vern-da-coda/lasius/docs/README.md

# Lasius Hexapod: Documentation

---

[Index](../README.md) | [Software](../software/README.md) | [Hardware](../hardware/README.md) | [Docs](../docs/README.md) | [Data](../data/README.md) | [Scripts](../scripts/README.md) |<br>
[Domain Architecture](domain_architecture.md) | [Decisions](hardware/decisions.md) | [Closed Loop](hardware/closed_loop_plan.md) | [Wiring](hardware/wiring_plan.md) | [Gamepad](pilot/gamepad_stadia.md) | [Roadmap](roadmap.md) |

---

Specifications, architectural decisions, wiring schematics, and development roadmaps for the **Lasius** 18-DOF Hexapod robot.

**Interactive 3D Digital Twin Demo:** [**https://dashboard.lasius.kaemmereit.de/**](https://dashboard.lasius.kaemmereit.de/) – Experience the browser-based simulation directly.

## Documentation Index

### System & Architecture
- [**System & Domain Architecture Specification**](domain_architecture.md):
  End-to-end domain map covering Mechanics (3-Level Hardware-as-Code), Power & Sensor Electronics, 50 Hz Harmonic Locomotion Core, 3D Digital Twin, Gamepad Teleoperation, PyBullet Physics, and Gymnasium Reinforcement Learning.
- [**Audio Podcast Architecture Briefing**](audio_briefing_domain.md):
  Audio learning script covering physical CAD modeling, PyBullet simulation, kinematics, and software architecture.

### Hardware & Electronics
- [**Electronics Testbench Bring-Up Status & Handover**](hardware/testbench_bringup_status.md):
  **Active Focus:** Status of the 6-step bench Bring-Up for the TCA9548A I2C multiplexer and ADS1115 16-bit ADCs.
- [**Electronics Testbench Reference Guide**](hardware/electronics_testbench_guide.md):
  Technical guide with exact wiring tables, 3.3V logic protection, I2C address topology, and diagnostic procedures.
- [**Hardware Decisions & 3D Printing Specifications**](hardware/decisions.md):
  Comprehensive documentation of the physical architecture: 2S LiPo battery, 20A UBEC (6.0V servo bus), 5V/3A buck converter for Raspberry Pi, Adafruit STEMMA QT / Qwiic I2C sensor bus topology, BNO085 9-DOF IMU, INA228 power monitors, VL53L4CD ToF distance sensors, MCP23017 foot switch expander, and slicer/material settings for PETG limb parts.
- [**18-DOF Closed-Loop Feedback Plan**](hardware/closed_loop_plan.md):
  Architecture for closed-loop angle feedback by tapping internal servo potentiometers into 6× ADS1115 16-bit ADCs via a TCA9548A I2C multiplexer with 100 nF RC low-pass filtering.
- [**Electrical Wiring & Connection Plan**](hardware/wiring_plan.md):
  Detailed pinouts, bus addresses, and terminal blocks for the dual PCA9685 PWM drivers, sensor bus, and power distribution rails.

### Teleoperation & Controls
- [**Google Stadia Controller & Teleoperation Guide**](pilot/gamepad_stadia.md):
  Linux joystick driver (`/dev/input/js0`), raw axis mappings, button layouts, deadzone filtering, and Bluetooth pairing instructions for the Google Stadia Controller.

### Project Roadmap
- [**Project Roadmap & Backlog**](roadmap.md):
  Prioritized task list, sprint backlog, mechanical reconstruction goals, and feature milestones.
