vern-da-coda/lasius/hardware/mechanics/drawings/references/ads1115_reference.jpg

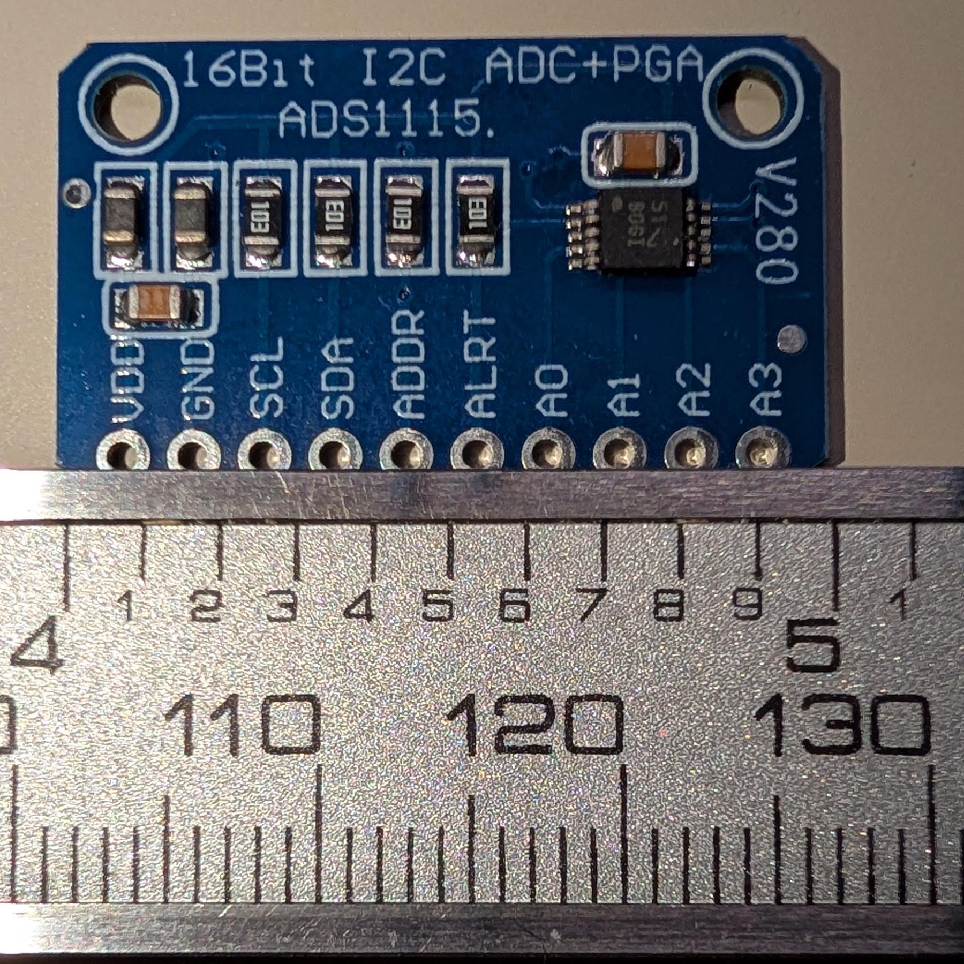
hardware/mechanics/drawings/references/ads1115_reference.jpg
