vern-da-coda/lasius/hardware/mechanics/drawings/sketches/femur_servo_wangen.png

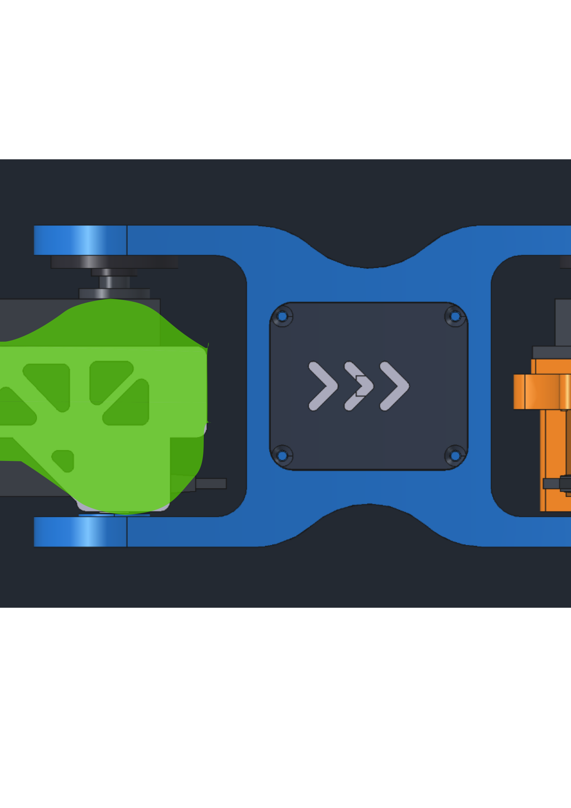
hardware/mechanics/drawings/sketches/femur_servo_wangen.png
