vern-da-coda/lasius/hardware/mechanics/export/sim_preview.png

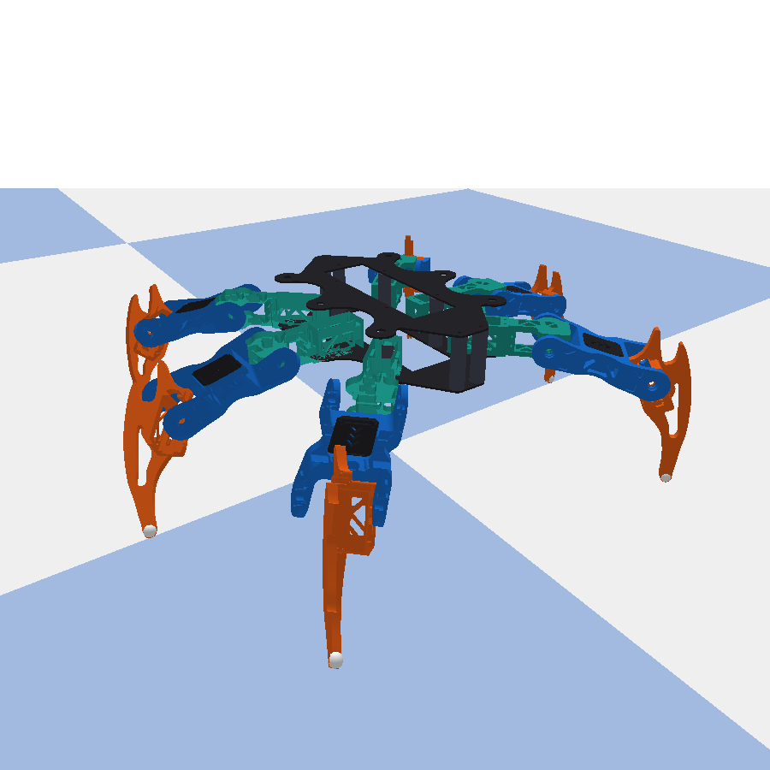
hardware/mechanics/export/sim_preview.png
