vern-da-coda/lasius/hardware/electronics/wiring/02_single_leg_feedback_harness.bom.tsv

Id | Description | Qty | Unit | Designators
1 | Cable, 1 x 28 AWG | 0.58 | m | Coxa_Pot_Line, Femur_Pot_Line, Tibia_Pot_Line
2 | Cable, 2 x 28 AWG | 0.35 | m | Foot_Switch_Line
3 | Cable, 3 x 24 AWG | 0.64 | m | Coxa_Power_PWM, Femur_Power_PWM, Tibia_Power_PWM
4 | Cable, 4 x 28 AWG | 0.2 | m | SubBus_I2C_Feed
5 | Cable, 7 x 26 AWG | 0.01 | m | Direct_Header_Solder
6 | Connector, ADS1115 16-Bit ADC Breakout, Leg Telemetry Module (Addr 0x48), 9 pins, OG | 1 |  | ADS1115_Leg_Board
7 | Connector, Omron D2F-L Microswitch, Tactile Foot Contact (Active-Low), 2 pins, BK | 1 |  | Foot_Sensor
8 | Connector, PCA9685 4-Channel Header Block, Channels 4k, 4k+1, 4k+2 (4k+3 Spare), 12 pins, BU | 1 |  | PCA9685_Leg_Block
9 | Connector, Passive Filter + Pull-Up Network, Soldered Directly Under ADS1115 Header, 7 pins, YE | 1 |  | Onboard_RC_Pullup
10 | Connector, Reely NR-645 MG BB, Modified 4-Wire Servo (Coxa), 4 pins, GY | 1 |  | Servo_Coxa
11 | Connector, Reely NR-645 MG BB, Modified 4-Wire Servo (Femur), 4 pins, GY | 1 |  | Servo_Femur
12 | Connector, Reely NR-645 MG BB, Modified 4-Wire Servo (Tibia), 4 pins, GY | 1 |  | Servo_Tibia
13 | Connector, TCA9548A Sub-Channel Uplink (CHx), 4-Pin I2C + 3.3V Feed, 4 pins, BU | 1 |  | TCA9548A_SubBus
