vern-da-coda/lasius/hardware/mechanics/export/step/body_assembly.step

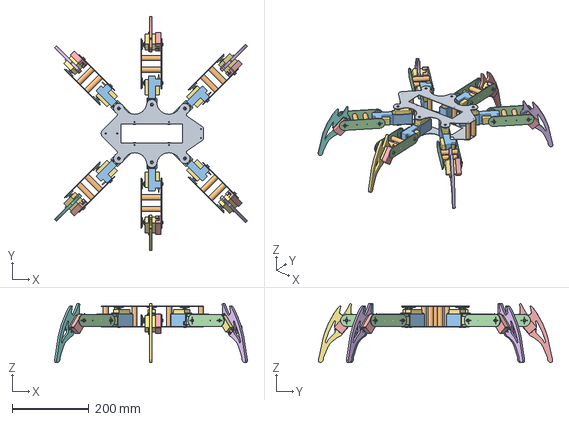
[picture p8: CAD file, 2026-11-07]
hardware/mechanics/export/step/body_assembly.step
502.7 x 610.7 x 154.1 mm
