vern-da-coda/lasius/hardware/mechanics/export/step/custom/v2/leg_assembly.step

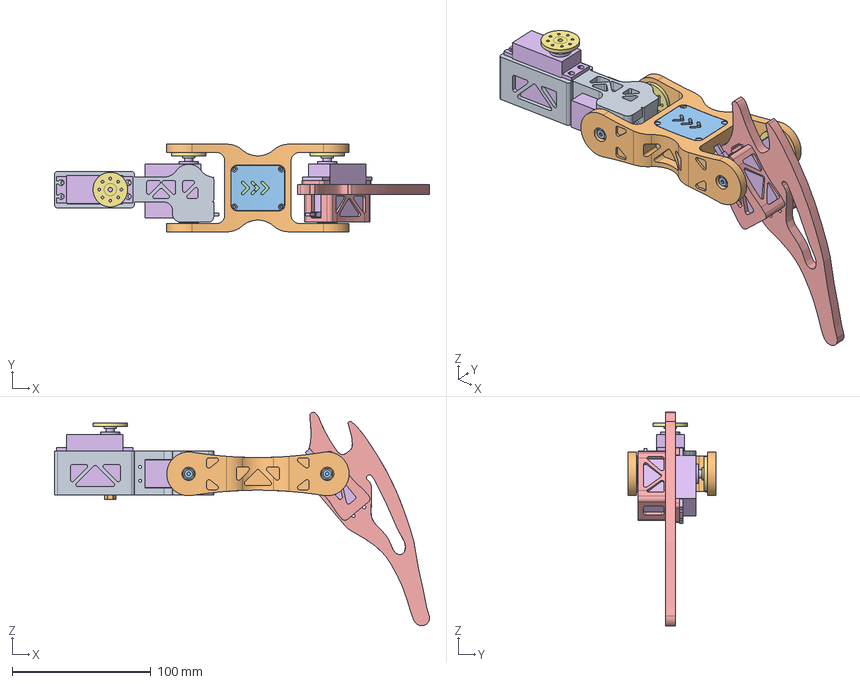
[picture p9: CAD file, 2026-11-09]
hardware/mechanics/export/step/custom/v2/leg_assembly.step
270.6 x 63.3 x 154.1 mm
