vern-da-coda/lasius/hardware/mechanics/export/step/custom/v2/body_assembly.step

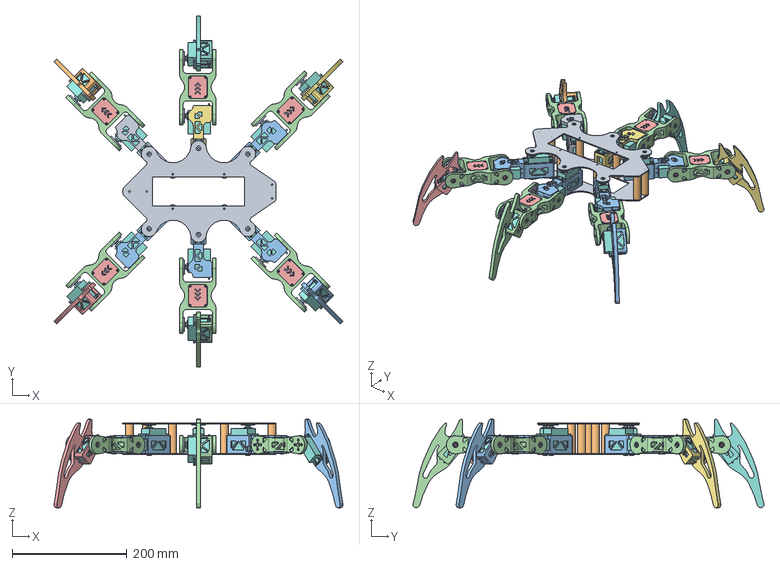
[picture p10: CAD file, 2026-11-09]
hardware/mechanics/export/step/custom/v2/body_assembly.step
502.7 x 610.7 x 154.1 mm
