vern-da-coda/lasius/hardware/mechanics/export/step/custom/v2/parts/coxa_bracket.step

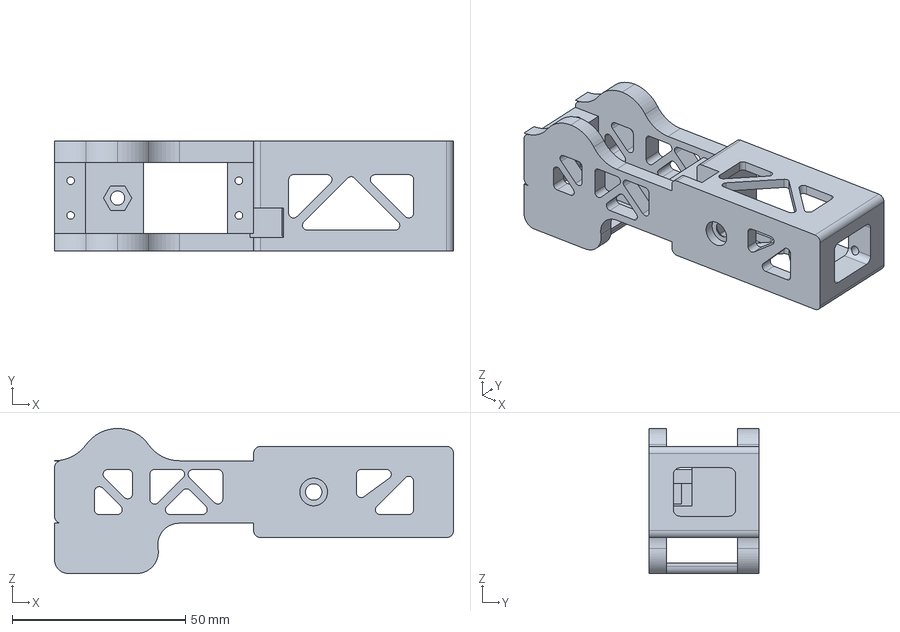
[picture p11: CAD file, 2026-11-09]
hardware/mechanics/export/step/custom/v2/parts/coxa_bracket.step
115.0 x 31.7 x 41.8 mm
