vern-da-coda/lasius/hardware/mechanics/export/stl/custom/v2/parts/femur_cover.stl

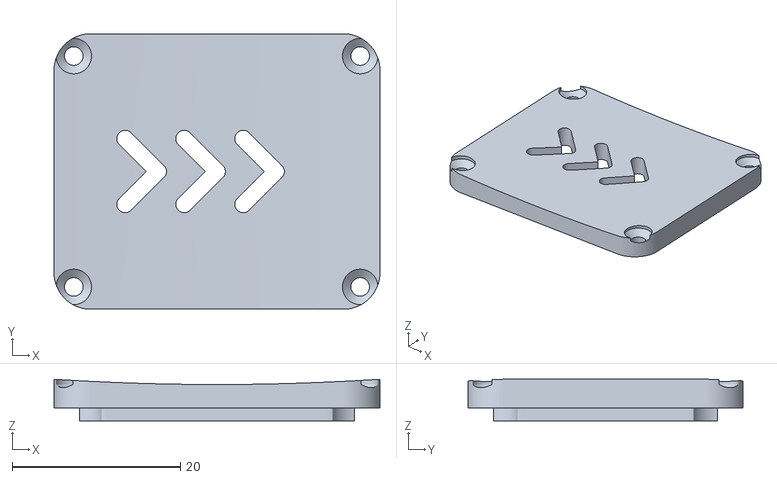
[picture p12: CAD file, 2026-11-09]
hardware/mechanics/export/stl/custom/v2/parts/femur_cover.stl
38.7 x 32.7 x 4.93
