vern-da-coda/lasius/hardware/mechanics/export/step/custom/v2/parts/femur.step

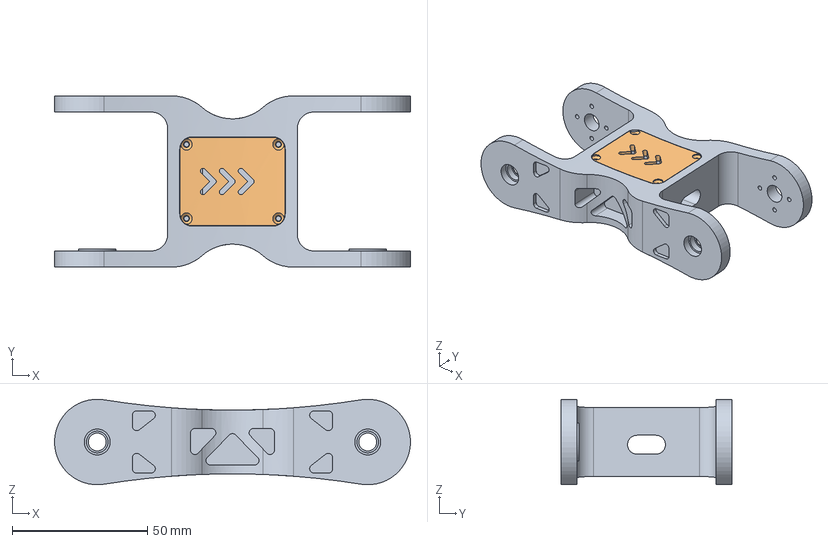
[picture p13: CAD file, 2026-11-08]
hardware/mechanics/export/step/custom/v2/parts/femur.step
131.6 x 63.3 x 31.6 mm
