vern-da-coda/lasius/hardware/mechanics/export/step/custom/v2/parts/tibia.step

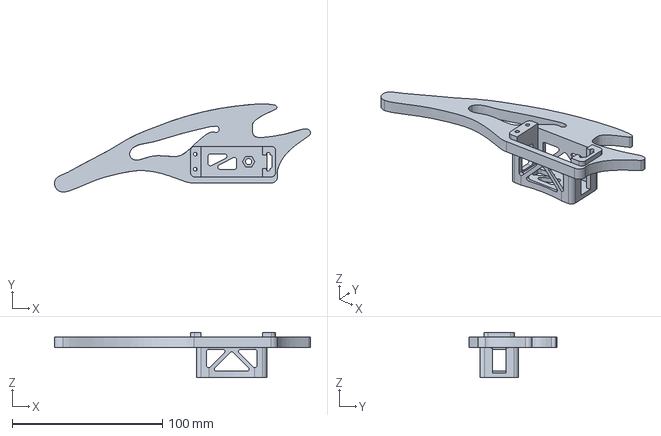
[picture p14: CAD file, 2026-11-08]
hardware/mechanics/export/step/custom/v2/parts/tibia.step
170.3 x 58.6 x 30.0 mm
