vern-da-coda/lasius/hardware/mechanics/export/step/cots/servo_nr645.step

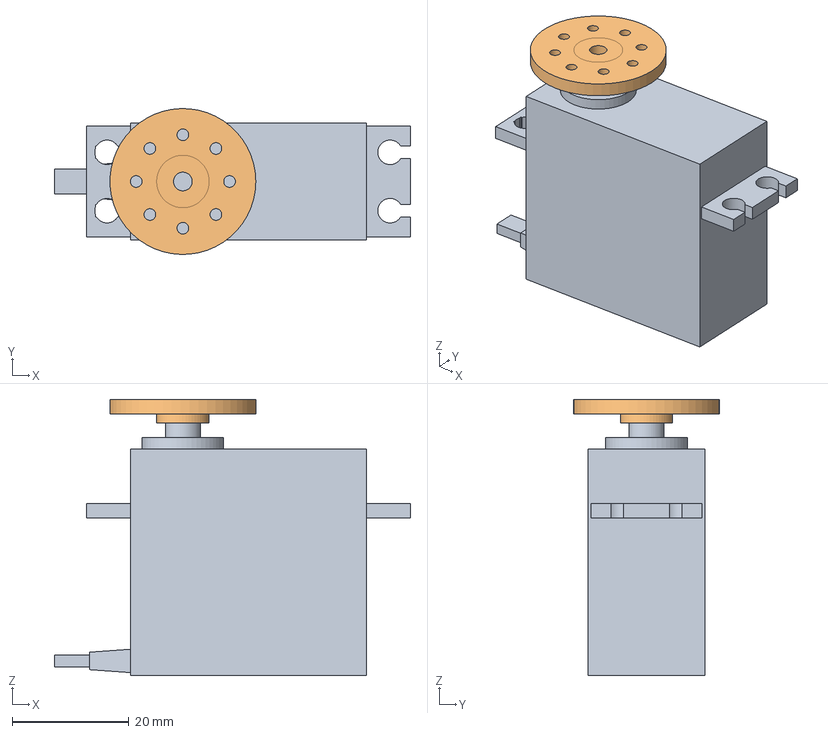
[picture p15: CAD file, 2026-11-06]
hardware/mechanics/export/step/cots/servo_nr645.step
61.0 x 25.0 x 47.3 mm
