vern-da-coda/lasius/hardware/mechanics/models/cots/nut_m4_din439.FCStd

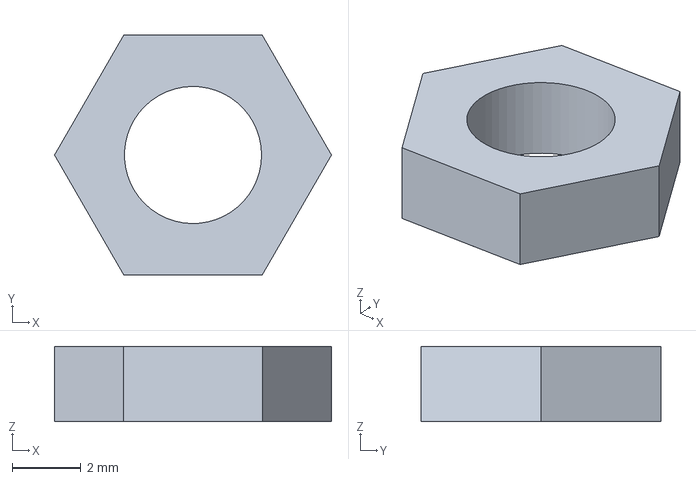
[picture p16: CAD file, 2026-11-09]
hardware/mechanics/models/cots/nut_m4_din439.FCStd
8.08 x 7.00 x 2.20 mm
