vern-da-coda/lasius/hardware/mechanics/models/cots/washer_m4_shim.FCStd

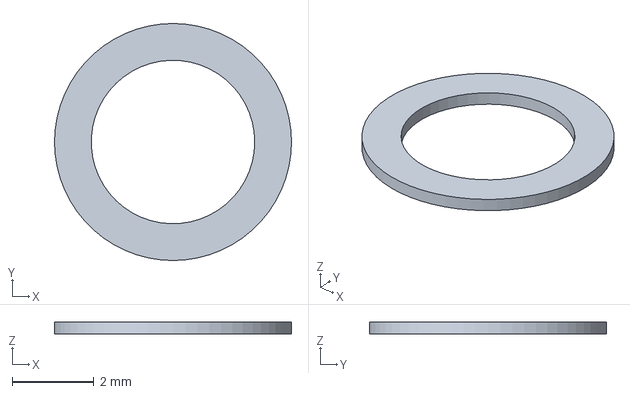
[picture p17: CAD file, 2026-11-06]
hardware/mechanics/models/cots/washer_m4_shim.FCStd
5.80 x 5.80 x 0.3 mm
