vern-da-coda/lasius/hardware/mechanics/models/cots/screw_m4_countersunk.FCStd

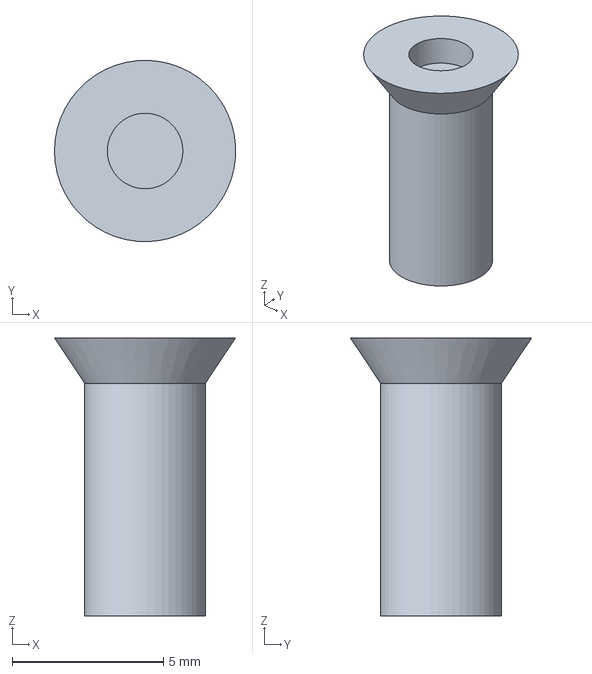
[picture p18: CAD file, 2026-11-06]
hardware/mechanics/models/cots/screw_m4_countersunk.FCStd
5.99 x 6.00 x 9.20 mm
