vern-da-coda/lasius/hardware/mechanics/models/cots/bearing_684_6x3.FCStd

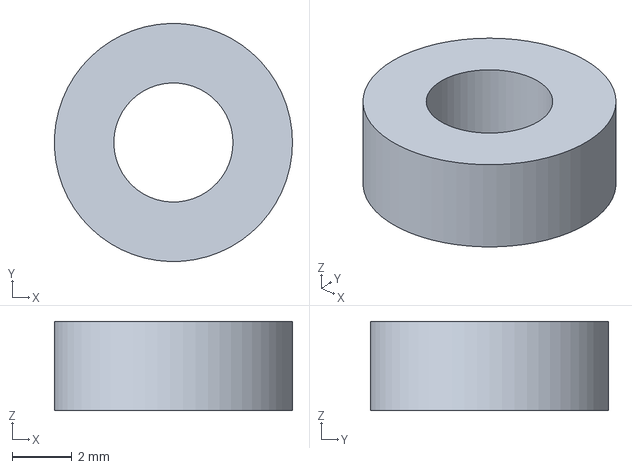
[picture p19: CAD file, 2026-11-06]
hardware/mechanics/models/cots/bearing_684_6x3.FCStd
7.99 x 8.00 x 3.00 mm
