vern-da-coda/lasius/hardware/mechanics/models/cots/nut_m4_hex.FCStd

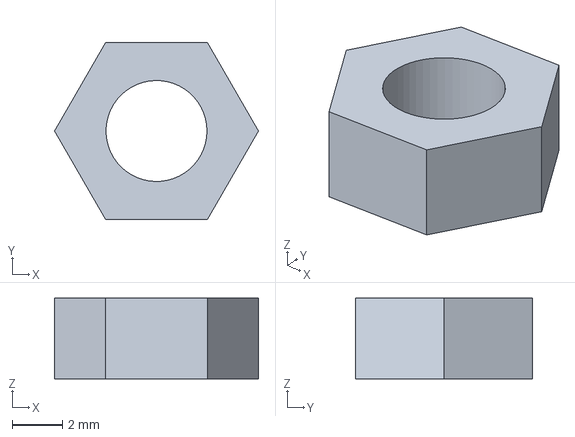
[picture p20: CAD file, 2026-11-06]
hardware/mechanics/models/cots/nut_m4_hex.FCStd
8.08 x 7.00 x 3.20 mm
