vern-da-coda/lasius/hardware/mechanics/export/step/custom/v1/leg_assembly.step

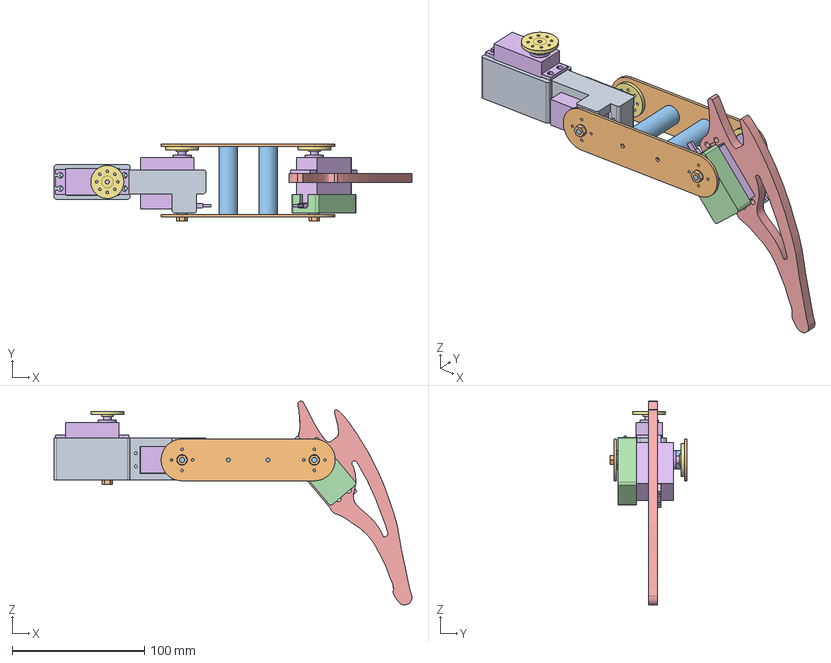
[picture p21: CAD file, 2026-11-09, an earlier design]
hardware/mechanics/export/step/custom/v1/leg_assembly.step
270.6 x 58.5 x 154.1 mm
