vern-da-coda/lasius/hardware/mechanics/export/step/custom/v1/parts/body_bottom.step

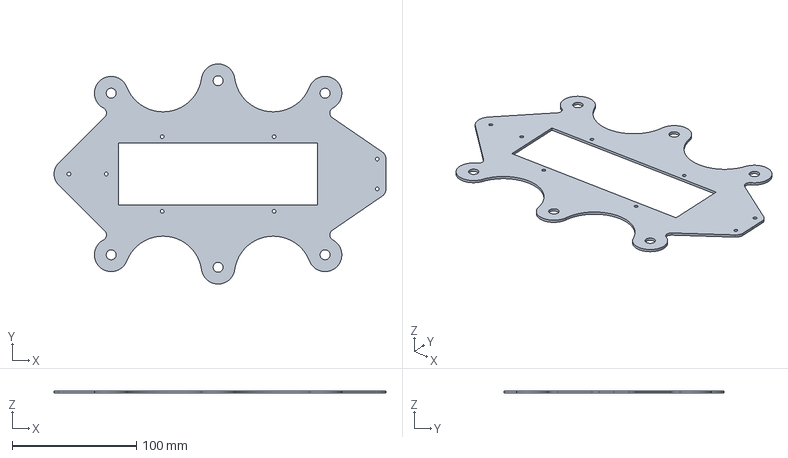
[picture p22: CAD file, 2026-11-07, an earlier design]
hardware/mechanics/export/step/custom/v1/parts/body_bottom.step
267.0 x 176.9 x 2.00 mm
