vern-da-coda/lasius/hardware/mechanics/export/step/custom/v1/parts/tibia_servo_foot.step

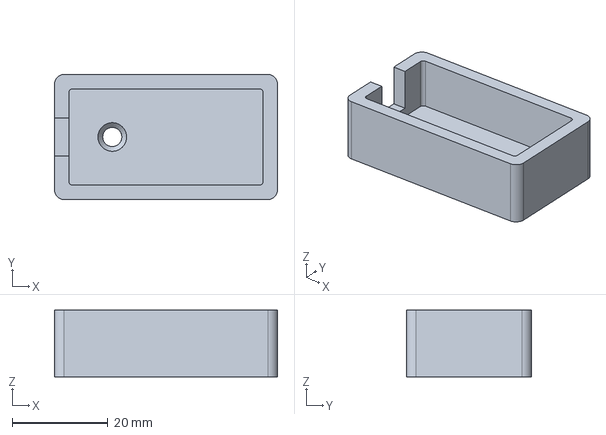
[picture p23: CAD file, 2026-11-06, an earlier design]
hardware/mechanics/export/step/custom/v1/parts/tibia_servo_foot.step
46.7 x 26.2 x 14.0 mm
