vern-da-coda/lasius/mechanics/models/tibia.scad

// ==============================================================================
// Lasius Hexapod - Tibia (Unterschenkel / Sichelkralle)
// Parametric CAD Model generated from 600 DPI calibrated flatbed scan
//
// Kinematic Reference: Knee Pivot Axis = (0, 0)
// Distance Knee Pivot to Foot Tip: 129.95 mm (nominal 130.0 mm DH kinematics)
// Servo: Torcster NR-645 MG BB 59g (standard 40.2 x 20.1 mm case)
// Plate thickness: 7.0 mm | Servo holes: 4.0 mm standalone through holes
// Foot tip: Tangential smooth circular rounding (R = 5.60 mm)
// Cable notch: [10.25..13.50] x [-2.40..2.40] between mounting holes
// ==============================================================================

$fn = 40;

// --- Parametric Parameters ---
tibia_thickness = 7.0;       // Plate thickness: 7.0 mm
servo_hole_dia  = 4.0;       // Servo mounting holes: 4.0 mm through hole
foot_hole_dia   = 3.0;       // Foot accessory / bumper hole (M3): 3.0 mm

// Mode selector: "3d" for 3D model (default), "2d" for DXF/SVG laser export
mode = "3d";

// --- 2D Contours ---
outer_polygon = [
    [-129.15, -14.41], [-129.02, -13.42], [-128.73, -12.47], [-128.27, -11.58],
    [-127.66, -10.79], [-126.91, -10.12], [-126.07, -9.60], [-121.95, -7.92],
    [-112.64, -2.84], [-112.14, -2.82], [-112.07, -2.57], [-107.90, -0.30],
    [-93.27, 7.42], [-92.29, 7.80], [-91.74, 8.57], [-91.87, 9.74],
    [-77.05, 16.80], [-65.56, 21.71], [-62.43, 22.93], [-62.26, 22.86],
    [-62.03, 23.12], [-47.05, 28.51], [-37.39, 31.35], [-36.31, 31.48],
    [-30.28, 33.07], [-22.83, 34.72], [-9.97, 36.77], [1.42, 38.01],
    [8.59, 38.40], [12.44, 38.31], [15.88, 37.95], [17.57, 37.61],
    [18.08, 37.38], [18.70, 36.57], [18.65, 35.56], [18.10, 34.79],
    [17.85, 34.78], [16.71, 34.06], [15.31, 33.58], [8.03, 30.02],
    [4.62, 27.70], [2.85, 25.95], [2.70, 25.70], [2.42, 22.51],
    [2.55, 19.34], [2.86, 17.85], [2.79, 17.60], [3.24, 16.95],
    [4.68, 16.34], [6.45, 16.00], [9.04, 16.02], [12.95, 16.44],
    [23.07, 18.04], [25.64, 18.73], [26.88, 18.87], [28.78, 19.37],
    [29.20, 19.30], [29.28, 19.47], [29.78, 19.49], [30.02, 19.67],
    [30.20, 19.51], [30.36, 19.69], [30.53, 19.61], [30.68, 19.87],
    [31.52, 19.90], [31.59, 20.07], [33.58, 20.57], [35.24, 20.81],
    [35.25, 20.56], [35.49, 20.82], [35.40, 20.90], [38.46, 21.62],
    [39.30, 21.65], [40.32, 21.19], [40.76, 20.71], [41.13, 19.81],
    [41.15, 19.22], [40.94, 18.38], [40.23, 17.35], [37.94, 16.16],
    [31.60, 11.97], [26.75, 8.25], [24.50, 6.15], [21.88, 2.95],
    [20.47, 0.55], [20.05, -1.22], [20.07, -1.72], [19.91, -1.90],
    [20.00, -2.06], [19.64, -3.41], [19.46, -5.09], [18.42, -8.14],
    [17.10, -10.45], [16.13, -11.33], [15.72, -11.43], [15.64, -11.52],
    [15.81, -11.59], [14.49, -11.98], [14.42, -12.24], [14.07, -12.00],
    [13.84, -12.35], [13.59, -12.36], [13.41, -12.11], [13.26, -12.45],
    [12.92, -12.38], [11.26, -12.71], [11.28, -13.04], [10.96, -13.39],
    [10.00, -14.25], [-36.00, -14.25], [-37.50, -15.44], [-37.51, -15.19],
    [-38.19, -14.80], [-44.65, -12.15], [-52.37, -9.39], [-56.95, -8.00],
    [-61.25, -6.93], [-65.29, -6.18], [-71.58, -5.78], [-75.33, -5.94],
    [-78.90, -6.34], [-83.14, -7.02], [-86.28, -7.82], [-86.53, -7.83],
    [-86.72, -7.26], [-87.15, -6.94], [-87.90, -6.89], [-96.28, -10.25],
    [-96.86, -10.44], [-97.03, -10.28], [-97.11, -10.54], [-99.49, -11.39],
    [-100.72, -12.03], [-103.44, -12.98], [-112.97, -16.81], [-113.54, -17.08],
    [-115.06, -18.73], [-122.54, -20.11], [-123.53, -20.20], [-124.53, -20.11],
    [-125.49, -19.85], [-126.39, -19.42], [-127.21, -18.84], [-127.90, -18.13],
    [-128.46, -17.30], [-128.86, -16.38], [-129.09, -15.41]
];

slot_polygon = [
    [-79.15, 5.26], [-78.95, 6.44], [-78.79, 6.70], [-77.32, 7.43],
    [-75.67, 8.00], [-75.51, 8.17], [-72.06, 9.57], [-69.67, 10.34],
    [-67.70, 11.18], [-67.28, 11.20], [-67.04, 11.46], [-65.06, 12.04],
    [-64.74, 12.39], [-64.41, 12.49], [-64.32, 12.33], [-64.08, 12.42],
    [-63.92, 12.68], [-63.58, 12.61], [-61.94, 13.35], [-61.61, 13.36],
    [-60.38, 13.91], [-57.66, 14.78], [-57.50, 14.95], [-55.19, 15.55],
    [-54.53, 15.92], [-52.14, 16.69], [-47.68, 17.88], [-47.36, 18.06],
    [-46.94, 18.08], [-43.64, 19.14], [-40.26, 20.03], [-38.93, 20.25],
    [-38.85, 20.42], [-38.43, 20.36], [-37.03, 20.75], [-30.23, 22.04],
    [-28.74, 22.44], [-21.69, 23.58], [-21.02, 23.52], [-20.51, 23.29],
    [-19.90, 22.65], [-19.71, 22.07], [-19.67, 21.16], [-20.29, 20.13],
    [-21.03, 19.76], [-22.19, 19.54], [-24.32, 18.70], [-27.68, 17.06],
    [-30.45, 15.27], [-33.03, 13.24], [-35.19, 10.97], [-39.55, 5.44],
    [-40.52, 4.56], [-41.57, 3.85], [-43.71, 2.92], [-44.70, 2.71],
    [-46.54, 2.64], [-55.02, 3.70], [-60.57, 4.55], [-62.75, 4.71],
    [-66.09, 4.73], [-70.84, 4.36], [-73.25, 4.01], [-76.39, 3.29],
    [-78.29, 2.71], [-78.45, 2.54], [-78.78, 2.61], [-78.97, 3.02],
    [-79.15, 5.26]
];

// Servo cutout with cable exit notch centered between the two mounting holes
servo_window_polygon = [
    [-30.25, -10.25],
    [10.25, -10.25],
    [10.25, -2.40],
    [13.50, -2.40],
    [13.50, 2.40],
    [10.25, 2.40],
    [10.25, 10.25],
    [-30.25, 10.25]
];

// 2D Profile
module tibia_2d() {
    difference() {
        polygon(outer_polygon);
        polygon(slot_polygon);
        polygon(servo_window_polygon);
        
        // 4x Standalone Servo mounting holes (Ø 4.0 mm)
        translate([14.15, 5.00]) circle(d = servo_hole_dia);
        translate([14.15, -5.00]) circle(d = servo_hole_dia);
        translate([-34.35, 5.00]) circle(d = servo_hole_dia);
        translate([-34.35, -5.00]) circle(d = servo_hole_dia);
        
        // Foot bumper / accessory hole (Ø 3.0 mm)
        translate([-93.00, -11.50]) circle(d = foot_hole_dia);
    }
}

// 3D Model
module tibia_3d() {
    linear_extrude(height = tibia_thickness, convexity = 10)
        tibia_2d();
}

// Render selection
if (mode == "2d") {
    tibia_2d();
} else {
    tibia_3d();
}
