vern-da-coda/lasius/(list of files, cad)

Other CAD files:
hardware/mechanics/export/step/custom/v1/body_assembly.step
hardware/mechanics/export/step/custom/v1/parts/body_top.step
hardware/mechanics/export/dxf/custom/v1/parts/body_bottom.dxf
hardware/mechanics/export/dxf/custom/v1/parts/body_top.dxf
hardware/mechanics/export/dxf/custom/v1/parts/coxa_bracket.dxf
hardware/mechanics/export/dxf/custom/v1/parts/femur_plate.dxf
hardware/mechanics/export/dxf/custom/v1/parts/tibia.dxf
hardware/mechanics/export/step/custom/v1/parts/coxa_bracket.step
hardware/mechanics/export/step/custom/v1/parts/femur_plate.step
hardware/mechanics/export/step/custom/v1/parts/spacer_14x50.step
hardware/mechanics/export/step/custom/v1/parts/tibia.step
hardware/mechanics/export/stl/cots/servo_nr645.stl
hardware/mechanics/export/stl/custom/v1/leg_assembly.stl
hardware/mechanics/export/stl/custom/v1/parts/body_bottom.stl
hardware/mechanics/export/stl/custom/v1/parts/body_top.stl
hardware/mechanics/export/stl/custom/v1/parts/coxa_bracket.stl
hardware/mechanics/export/stl/custom/v1/parts/femur_plate.stl
hardware/mechanics/export/stl/custom/v1/parts/spacer_14x50.stl
hardware/mechanics/export/stl/custom/v1/parts/tibia.stl
hardware/mechanics/export/stl/custom/v1/parts/tibia_servo_foot.stl
hardware/mechanics/export/stl/custom/v2/leg_assembly.stl
hardware/mechanics/export/stl/custom/v2/parts/coxa_bracket.stl
hardware/mechanics/export/stl/custom/v2/parts/femur.stl
hardware/mechanics/export/stl/custom/v2/parts/tibia.stl
hardware/mechanics/models/cots/servo_nr645.FCStd
hardware/mechanics/models/custom/v1/body_assembly.FCStd
hardware/mechanics/models/custom/v1/leg_assembly.FCStd
hardware/mechanics/models/custom/v1/parts/body_bottom.FCStd
hardware/mechanics/models/custom/v1/parts/body_top.FCStd
hardware/mechanics/models/custom/v1/parts/coxa_bracket.FCStd
hardware/mechanics/models/custom/v1/parts/femur_plate.FCStd
hardware/mechanics/models/custom/v1/parts/spacer_14x50.FCStd
hardware/mechanics/models/custom/v1/parts/tibia.FCStd
hardware/mechanics/models/custom/v1/parts/tibia_servo_foot.FCStd
hardware/mechanics/models/custom/v2/body_assembly.FCStd
hardware/mechanics/models/custom/v2/leg_assembly.FCStd
hardware/mechanics/models/custom/v2/parts/coxa_bracket.FCStd
hardware/mechanics/models/custom/v2/parts/femur.FCStd
hardware/mechanics/models/custom/v2/parts/tibia.FCStd
