vern-da-coda/lasius/hardware/electronics/wiring/01_i2c_sensor_bus_topology.png

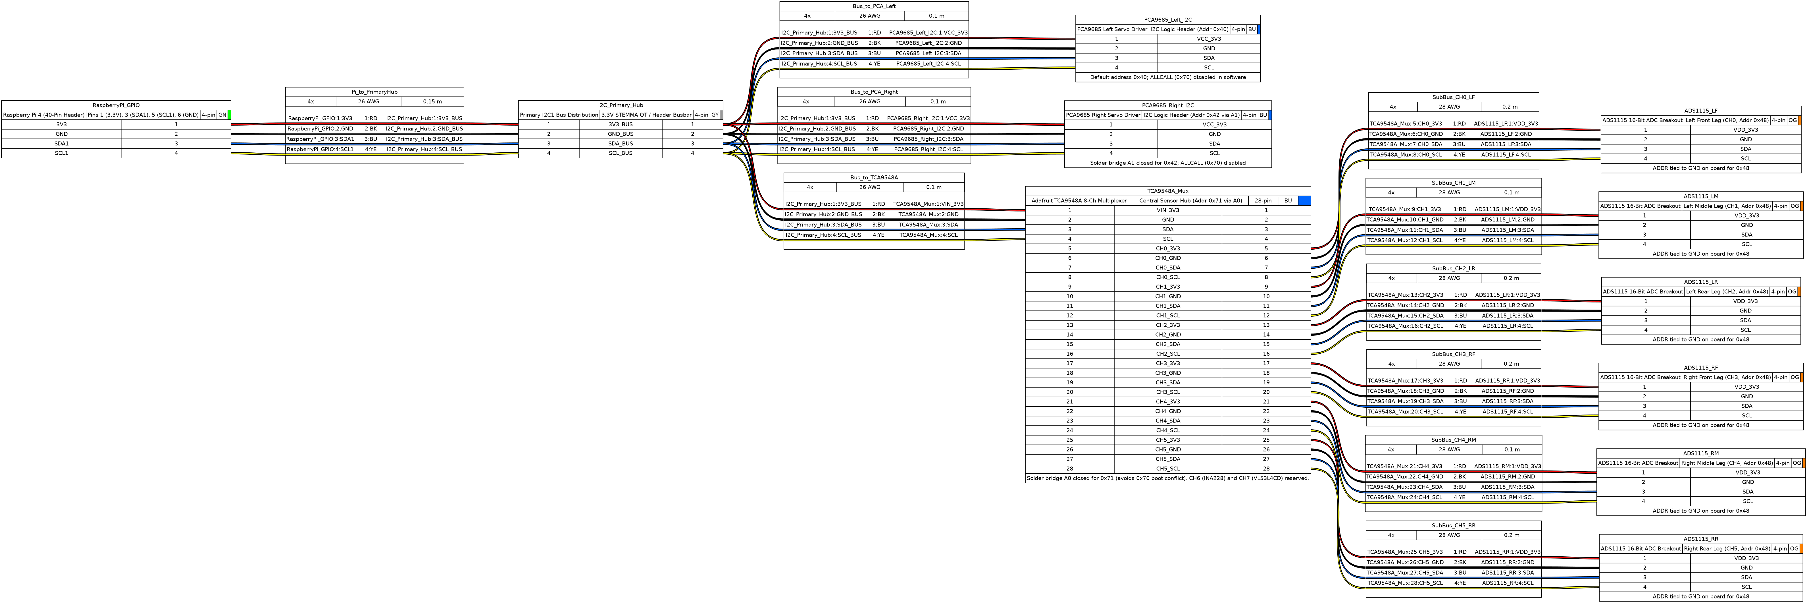
hardware/electronics/wiring/01_i2c_sensor_bus_topology.png
