vern-da-coda/lasius/hardware/electronics/wiring/02_single_leg_feedback_harness.png

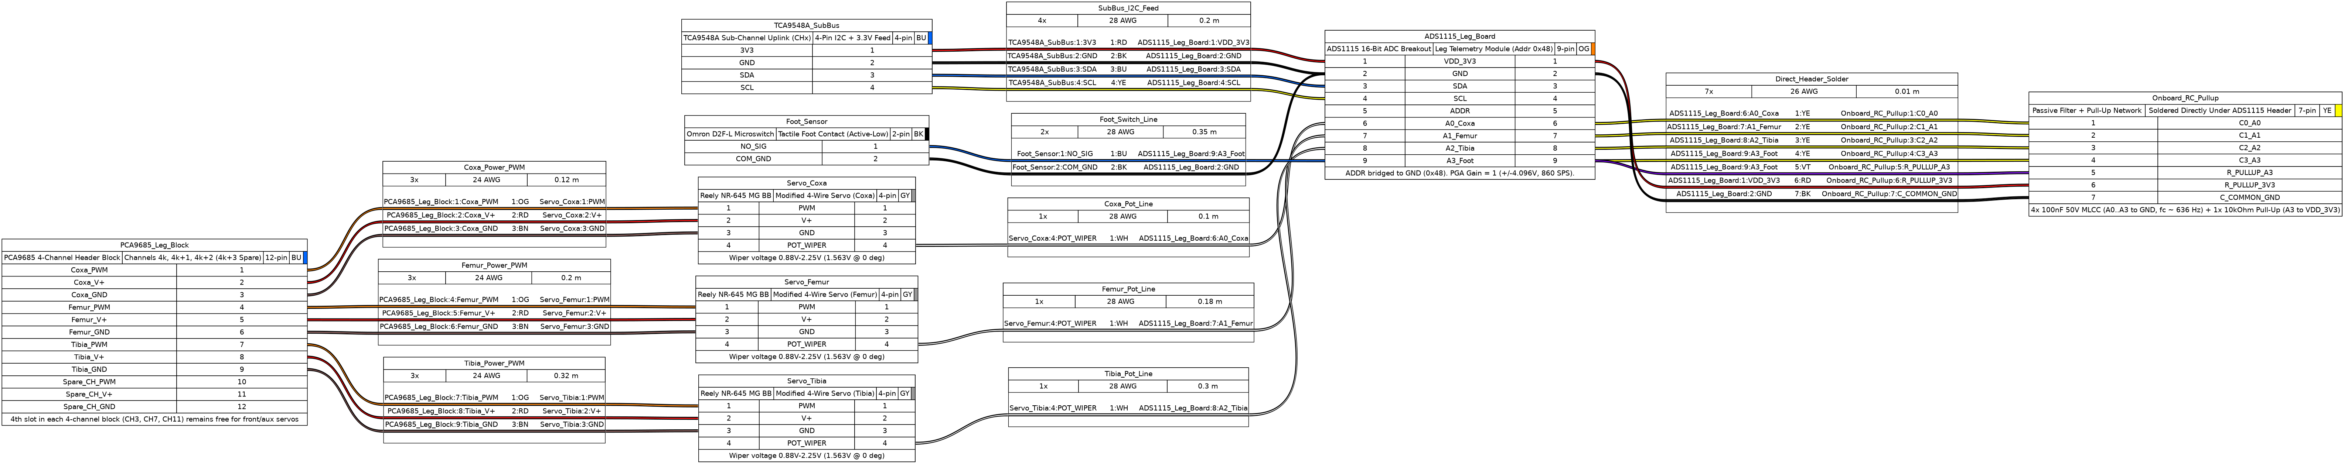
hardware/electronics/wiring/02_single_leg_feedback_harness.png
