vern-da-coda/lasius/hardware/electronics/wiring/03_power_distribution.png

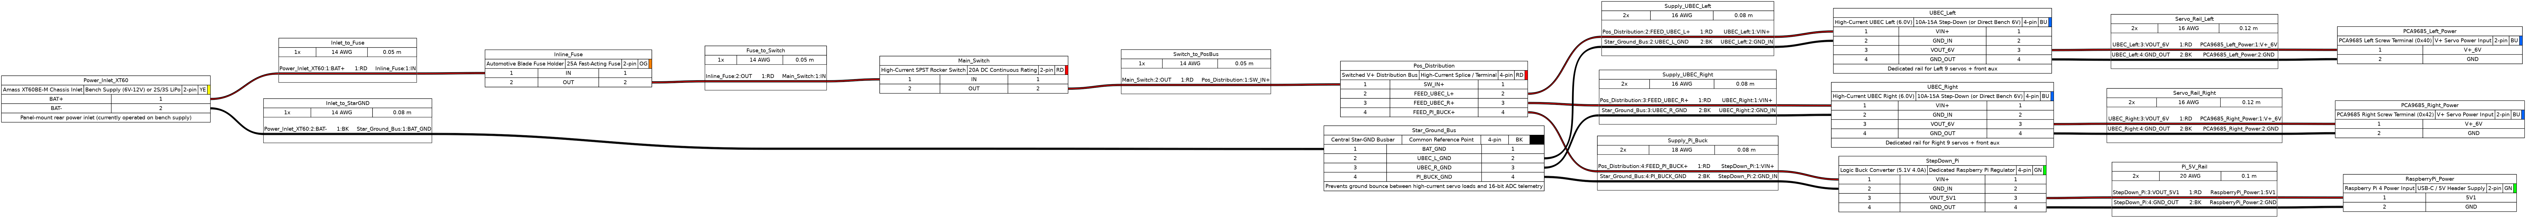
hardware/electronics/wiring/03_power_distribution.png
