vern-da-coda/lasius/hardware/electronics/wiring/04_pca9685_servo_distribution.png

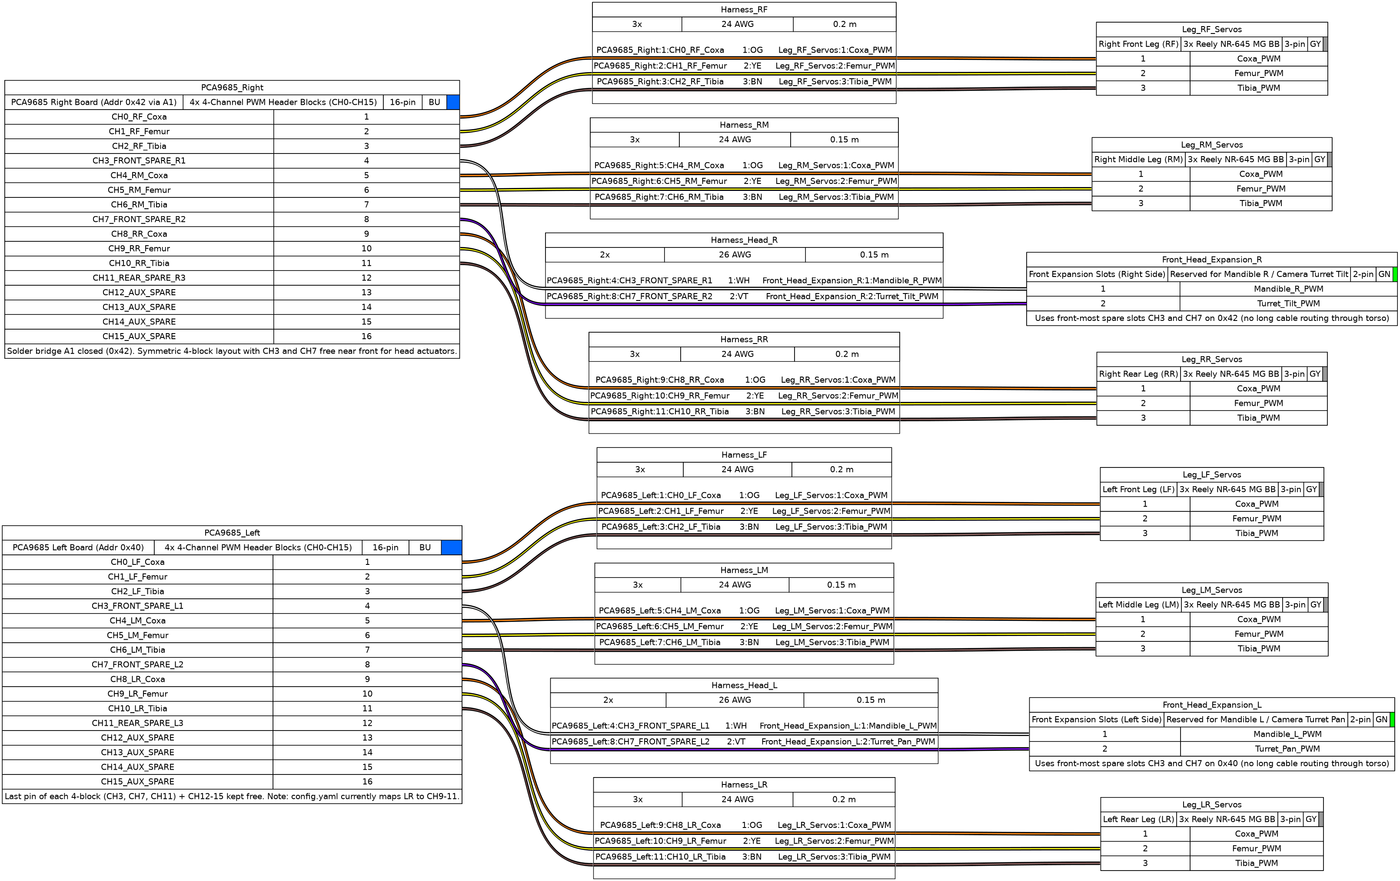
hardware/electronics/wiring/04_pca9685_servo_distribution.png
