vern-da-coda/lasius/data/calibration_backups/README.md

# Lasius Hexapod: Calibration Backups

---

[Index](../../README.md) | [Software](../../software/README.md) | [Hardware](../../hardware/README.md) | [Docs](../../docs/README.md) | [Data](../../data/README.md) | [Scripts](../../scripts/README.md) |<br>
[Bench Calibration](../../data/bench/README.md) | [Calibration Backups](../../data/calibration_backups/README.md) |

---

Local timestamped calibration snapshots retrieved from the physical Raspberry Pi via [`scripts/deploy/backup_calibration.sh`](../../scripts/deploy/backup_calibration.sh).

These JSON files store runtime potentiometer regression models and calibrated PWM servo endpoints for all 18 robot joints.
