vern-da-coda/lasius/data/bench/servo_ch15_pot_calibration.csv

step | angle_deg | pulse_us | measured_voltage_v | model_voltage_v | error_mv | error_deg
1 | -60.0 | 1166.7 | 1.11 | 1.108 | 2.0 | 0.26
2 | -45.0 | 1250.0 | 1.22 | 1.222 | -1.8 | -0.24
3 | -30.0 | 1333.3 | 1.34 | 1.336 | 4.3 | 0.57
4 | -15.0 | 1416.7 | 1.44 | 1.450 | -9.5 | -1.25
5 | 0.0 | 1500.0 | 1.57 | 1.563 | 6.7 | 0.88
6 | 15.0 | 1583.3 | 1.68 | 1.677 | 2.8 | 0.37
7 | 30.0 | 1666.7 | 1.78 | 1.791 | -11.0 | -1.45
8 | 45.0 | 1750.0 | 1.91 | 1.905 | 5.2 | 0.68
9 | 60.0 | 1833.3 | 2.02 | 2.019 | 1.3 | 0.18
