vern-da-coda/lasius/(commit log)

2026-11-06 feat(mechanics): construct full body assembly
    - Build 142-component full body master assembly (body_assembly.FCStd) linking chassis bottom/top plates, 8x standoff pillars, and 6x modular legs
    - Mirror right-side legs across sagittal plane (Y=0) so all 6 servo horn outputs face forward (-X) with 0.00000 mm coxa pivot axis alignment
    - Implement pure G1-continuous analytic geometry (44 faces, 126 edges) for both 2.0 mm solid chassis plates (body_bottom, body_top) with Rf=4.5 mm neck fillets
    - Translate all object labels and sub-feature names across all 14 .FCStd files and Python generator scripts to professional English
    - Standardize 1:1 workshop drill templates & drawings to vector SVG format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
    [bearing_684_6x3.FCStd, body_assembly.FCStd, body_bottom.FCStd, body_bottom.dxf, body_bottom.step, body_top.FCStd, body_top.dxf, body_top.step]
2026-11-07 feat(dashboard): align Three.js Digital Twin and 2D projections with FreeCAD CAD models
    - Transfer authentic FreeCAD chassis geometry (125-point B-Rep contour, 50x160mm window cutout, 6x coxa holes, 8x D14x51.3mm standoffs, 2.0mm dual plates)
    - Implement FreeCAD femur cage geometry (100mm pitch, 31.6mm width, 2.2mm plates with 51.3mm spacing and 2x D14 standoffs)
    - Transfer calibrated 600 DPI tibia sickle claw contour (147 outer points, 69 slot points, 7.0mm solid thickness)
    - Mirror right-side legs across sagittal plane so all 6 servo horns face forward (-Z in Three.js) matching body_assembly.FCStd
    - Update 2D orthographic projection strip (Top, Front, Side) to render the authentic sandwich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
2026-11-07 fix(chassis): correct body orientation (two transverse spacers front, centerline rear)
    - Invert longitudinal orientation of chassis hull and standoff positions:
    - 2x front standoffs placed side-by-side at Y = -128 mm (X = ±12 mm)
    - 2x rear standoffs placed inline along centerline at Y = +90 mm and +120 mm (X = 0 mm)
    - 4x central window standoffs preserved at X = ±30 mm, Y = ±45 mm
    - Flip chassis_contour.json longitudinally preserving CCW winding
    - Update 3D direction indicator and 2D orthographic projections (Top, Front, Side)
    - Rotate FreeCAD chassis plates (body_bottom, body_top, body_assembly) 180° around Z
    - Regenerate FreeCAD CAD models, STEP/DXF exports, and transparent READM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
    [body_assembly.FCStd, body_assembly.step, body_bottom.FCStd, body_bottom.dxf, body_bottom.step, body_bottom.stl, body_top.FCStd, body_top.dxf]
2026-11-07 feat(electronics): add WireViz cabling plans for closed-loop feedback
    - Implement 01_i2c_sensor_bus_topology.yml: TCA9548A 8-ch multiplexer hub
    routing isolated I2C channels CH0-CH5 to 6x ADS1115 leg ADCs
    - Implement 02_single_leg_feedback_harness.yml: 3-servo leg wiring with pot wiper
    feedback, 100nF MLCC low-pass noise filters (fc ≈ 636 Hz), and foot switch
    - Implement 03_power_distribution.yml: LiPo battery, dual regulators (UBEC 6V
    for servos, 5V for Pi), and star-ground topology
    - Generate SVG/PNG/HTML/TSV outputs and add wiring documentation
    [01_i2c_sensor_bus_topology.bom.tsv, 02_single_leg_feedback_harness.bom.tsv, 03_power_distribution.bom.tsv]
2026-11-07 build(deps): add wireviz to workspace dev dependencies
    - Add wireviz>=0.4.1 to [project.optional-dependencies] dev in root pyproject.toml
    - Update uv.lock to pin wireviz and dependencies (pillow, pygments, click, graphviz)
    - Enable running 'uv run wireviz' locally and in CI without global installation
2026-11-07 refactor(repo): reorganize project into hardware, docs, data, and scripts subdomains
    [01_i2c_sensor_bus_topology.bom.tsv, 02_single_leg_feedback_harness.bom.tsv, 03_power_distribution.bom.tsv, bearing_684_6x3.FCStd, body_assembly.FCStd, body_assembly.step, body_bottom.FCStd, body_bottom.dxf]
2026-11-07 docs(i18n): translate entire project documentation, scripts, and drawings to English
    [coxa_bracket.scad]
2026-11-07 docs: strip all non-ASCII characters, use Hexapod:Lasius, and embed wiring SVGs
2026-11-07 ci: configure environment name lasius.kaemmereit.de in deploy-plesk workflow
2026-11-07 fix(ci): remove CNAME file to host lasius.kaemmereit.de on Plesk webserver
2026-11-07 ci(deploy): switch to lftp for robust FTPS data socket transfer to Plesk
2026-11-07 docs(readme): add 50 Hz real-time WebSocket badge after OpenAPI
2026-11-07 docs(domain): update live demo domain to dashboard.lasius.kaemmereit.de
2026-11-08 docs(wiring): complete WireViz schematics, fix ADC/filter rails, and add PCA9685 servo distribution plan
    [01_i2c_sensor_bus_topology.bom.tsv, 02_single_leg_feedback_harness.bom.tsv, 03_power_distribution.bom.tsv, 04_pca9685_servo_distribution.bom.tsv, 04_pca9685_servo_distribution.yml]
2026-11-08 refactor(mechanics): organize CAD models and exports into hardware and custom/{v1,v2}[/parts]
    [body_assembly.FCStd, body_assembly.step, body_bottom.FCStd, body_bottom.dxf, body_bottom.step, body_bottom.stl, body_top.FCStd, body_top.dxf]
2026-11-08 feat(mechanics): update v2 assemblies with G1 tibia, truss cage and inverted counter-bearings
    - Smooth Tibia v2 claw contour with G1-continuous transitions and adapt base outline to servo mounts
    - Replace Tibia corner struts with a torsion-stiff 45-degree Warren truss cage
    - Implement internal M4 anti-rotation nut seat in Tibia and Coxa Bracket for monolithic Femur radial assembly
    - Update Femur v2 counter-bearing seat with external fastener entry and bearing stop lip
    - Add body_assembly v2 and coxa_bracket v2 models, generator scripts and exports
    [body_assembly.FCStd, body_assembly.step, coxa_bracket.FCStd, coxa_bracket.step, coxa_bracket.stl, femur.FCStd, femur.step, femur.stl]
2026-11-08 feat(mechanics): add coxa bracket v2 with 45-deg truss gusset and weight-relief cutouts
    [body_assembly.FCStd, body_assembly.step, coxa_bracket.FCStd, coxa_bracket.step, coxa_bracket.stl, leg_assembly.FCStd, leg_assembly.step, leg_assembly.stl]
2026-11-08 style(mechanics): hide internal origin coordinate planes in leg_assembly
    [leg_assembly.FCStd]
2026-11-08 feat(mechanics): implement 45-deg A-truss chevron windows in coxa bracket v2
    [body_assembly.FCStd, body_assembly.step, coxa_bracket.FCStd, coxa_bracket.step, coxa_bracket.stl, leg_assembly.FCStd, leg_assembly.step, leg_assembly.stl]
2026-11-08 feat(mechanics): add 45-deg A-truss flank pockets and chevron cheek ribs to femur v2
    [body_assembly.FCStd, body_assembly.step, femur.FCStd, femur.step, femur.stl, femur_cover.stl, leg_assembly.FCStd, leg_assembly.step]
2026-11-08 feat(mechanics): add 45-deg A-truss windows to coxa servo casing
    [body_assembly.FCStd, body_assembly.step, coxa_bracket.FCStd, coxa_bracket.step, coxa_bracket.stl, leg_assembly.FCStd, leg_assembly.step, leg_assembly.stl]
2026-11-09 refactor(mechanics): rename models/hardware to models/cots and update v2 backlog
    [bearing_684_6x3.FCStd, body_assembly.FCStd, body_assembly.step, coxa_bracket.FCStd, coxa_bracket.step, coxa_bracket.stl, leg_assembly.FCStd, leg_assembly.step]
2026-11-09 feat(sim): add URDF export and physics simulation pipeline for PyBullet and MuJoCo
    [body_bottom.stl, body_top.stl, coxa_bracket.stl, femur.stl, femur_cover.stl, femur_plate.stl, lasius.urdf, leg_assembly.stl]
2026-11-09 fix(sim): keep PyBullet GUI window open in interactive loop
    [run_simulation.py]
2026-11-09 fix(sim): correct URDF joint origins, leg mesh transforms and standing posture
    [lasius.urdf]
2026-11-09 feat(sim): dock lasius-dashboard with real-time 3D joint streaming to PyBullet
    - add SimHttpServer on port 8000 serving lasius-dashboard dist and REST endpoints
    - stream 18 IK joint angles (~25 Hz) and telemetry state (~10 Hz) over WebSocket
    - support bidirectional UI commands (gait, velocity, height, e-stop) in simulation
    - integrate dashboard lifecycle and URL reporting into sim_pilot.sh
    - drain incoming telemetry in lasius-pilot cli to prevent socket stall
    [run_simulation.py]
2026-11-09 feat(sim): support single-leg direct drive, sweeps, and relaxation in PyBullet
    - add joint_overrides and relaxed_servos tracking in SimWebSocketServer
    - handle set_joint_angle, set_leg_joints, stance_leg, and relax_leg
    - implement threaded collision sweeps and harmonic step cycles on isolated legs
    - automatically clear leg overrides when locomotion velocity is commanded
    - apply force=0.0 in PyBullet when joints or legs are relaxed
    [run_simulation.py]
2026-11-09 fix(sim): invert coxa/femur axes and apply tibia 90deg offset for pybullet
    [run_simulation.py]
